les2ki/Biometric-Attendance/Firmware/view frame.py/frame_231503.png

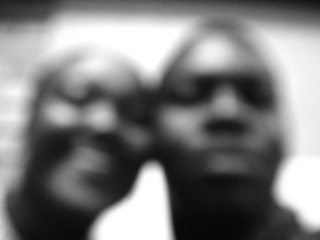
Firmware/view frame.py/frame_231503.png
