les2ki/Biometric-Attendance/Firmware/view frame.py/frame.png

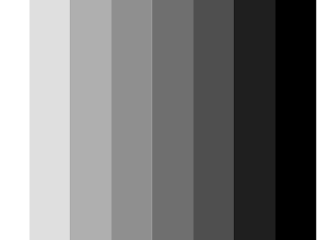
Firmware/view frame.py/frame.png
