les2ki/Biometric-Attendance/Firmware/view frame.py/frame_052043.png

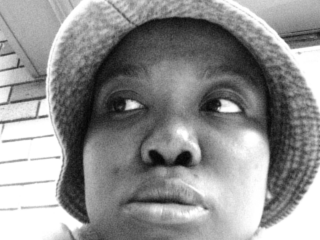
Firmware/view frame.py/frame_052043.png
