les2ki/Biometric-Attendance/Firmware/view frame.py/frame_225407.png

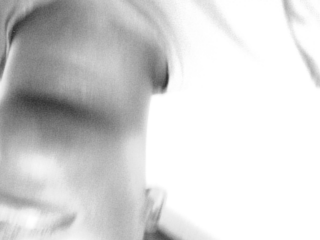
Firmware/view frame.py/frame_225407.png
