les2ki/Biometric-Attendance/Firmware/view frame.py/frame_225836_1.png

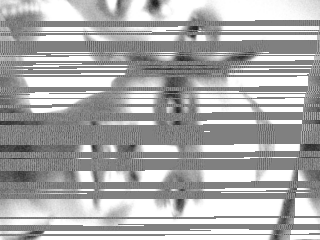
Firmware/view frame.py/frame_225836_1.png
