les2ki/Biometric-Attendance/Firmware/view frame.py/frame_225837_2.png

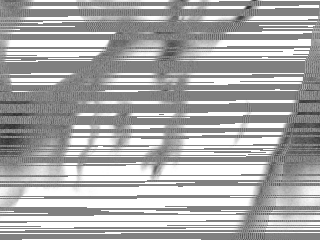
Firmware/view frame.py/frame_225837_2.png
