les2ki/Biometric-Attendance/Firmware/view frame.py/frame_225838_3.png

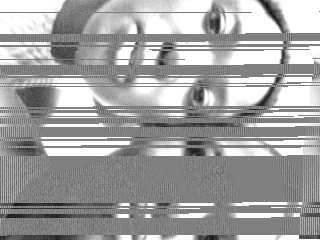
Firmware/view frame.py/frame_225838_3.png
