les2ki/Biometric-Attendance/Firmware/view frame.py/frame_225839_4.png

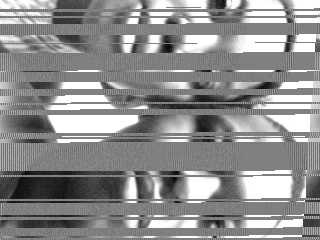
Firmware/view frame.py/frame_225839_4.png
