les2ki/Biometric-Attendance/Firmware/view frame.py/frame_225841_5.png

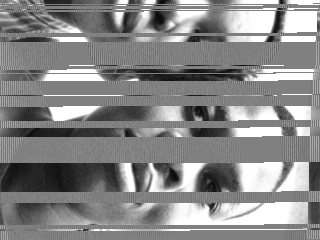
Firmware/view frame.py/frame_225841_5.png
