les2ki/Biometric-Attendance/Firmware/view frame.py/frame_225950_1.png

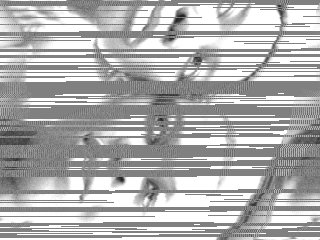
Firmware/view frame.py/frame_225950_1.png
