les2ki/Biometric-Attendance/Firmware/view frame.py/frame_225951_2.png

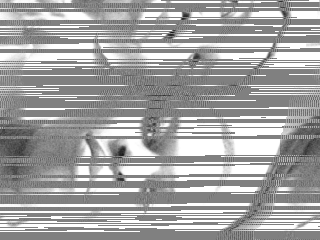
Firmware/view frame.py/frame_225951_2.png
