les2ki/Biometric-Attendance/Firmware/view frame.py/frame_225953_3.png

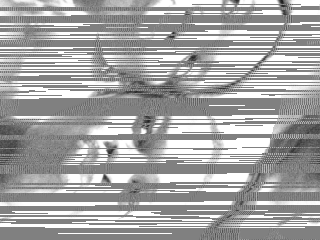
Firmware/view frame.py/frame_225953_3.png
