les2ki/Biometric-Attendance/Firmware/view frame.py/frame_225955_5.png

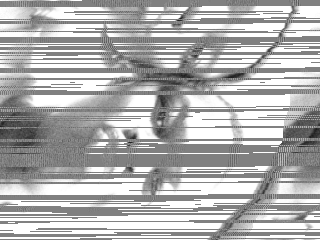
Firmware/view frame.py/frame_225955_5.png
