les2ki/Biometric-Attendance/Firmware/view frame.py/frame_231346_1.png

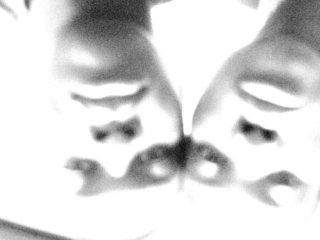
Firmware/view frame.py/frame_231346_1.png
