les2ki/Biometric-Attendance/Firmware/view frame.py/frame_231349_4.png

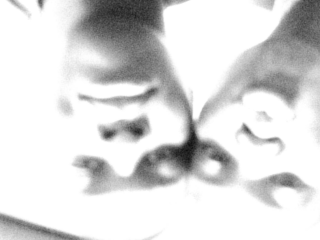
Firmware/view frame.py/frame_231349_4.png
