les2ki/Biometric-Attendance/Firmware/view frame.py/frame_231351_5.png

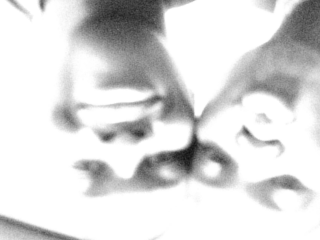
Firmware/view frame.py/frame_231351_5.png
