les2ki/Biometric-Attendance/Firmware/view frame.py/frame_231426.png

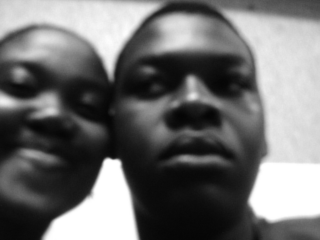
Firmware/view frame.py/frame_231426.png
