les2ki/Biometric-Attendance/Firmware/view frame.py/frame_231558.png

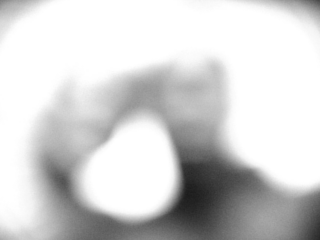
Firmware/view frame.py/frame_231558.png
