les2ki/Biometric-Attendance/Firmware/view frame.py/frame_231648.png

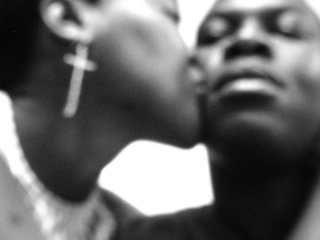
Firmware/view frame.py/frame_231648.png
