les2ki/Biometric-Attendance/Firmware/view frame.py/frame_231716.png

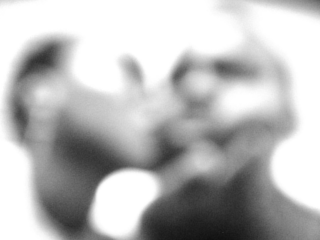
Firmware/view frame.py/frame_231716.png
