les2ki/Biometric-Attendance/Firmware/view frame.py/frame_231738.png

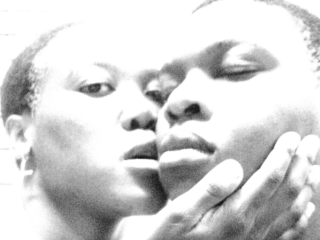
Firmware/view frame.py/frame_231738.png
