les2ki/Biometric-Attendance/Firmware/view frame.py/frame_231757.png

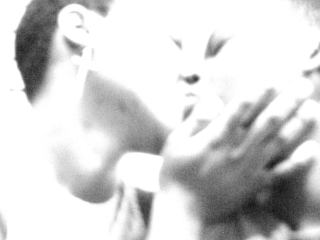
Firmware/view frame.py/frame_231757.png
