les2ki/Biometric-Attendance/Firmware/view frame.py/frame_231826.png

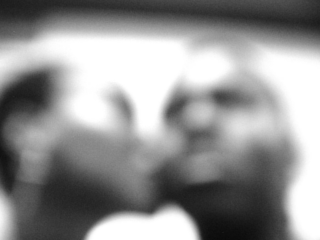
Firmware/view frame.py/frame_231826.png
