les2ki/Biometric-Attendance/Firmware/view frame.py/frame_231942.png

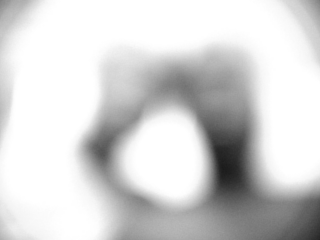
Firmware/view frame.py/frame_231942.png
