les2ki/Biometric-Attendance/Firmware/view frame.py/frame_232049.png

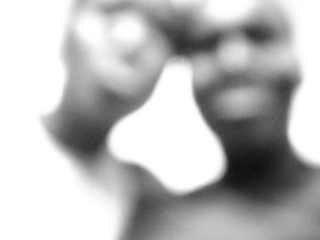
Firmware/view frame.py/frame_232049.png
