les2ki/Biometric-Attendance/Firmware/view frame.py/frame_232115.png

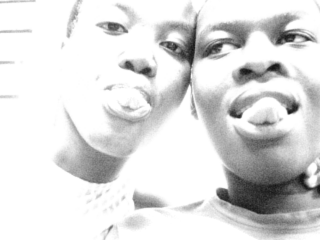
Firmware/view frame.py/frame_232115.png
