les2ki/Biometric-Attendance/Firmware/view frame.py/frame_232150.png

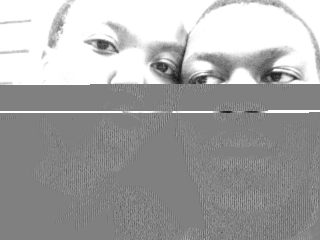
Firmware/view frame.py/frame_232150.png
