les2ki/Biometric-Attendance/Firmware/view frame.py/frame_232150_stretched.png

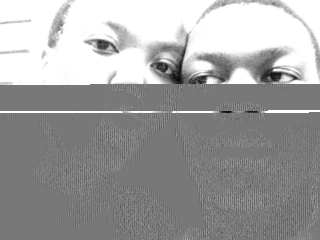
Firmware/view frame.py/frame_232150_stretched.png
