les2ki/Biometric-Attendance/Firmware/view frame.py/frame_232219.png

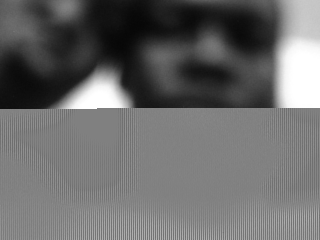
Firmware/view frame.py/frame_232219.png
