les2ki/Biometric-Attendance/Firmware/view frame.py/frame_232310.png

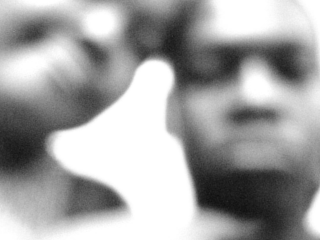
Firmware/view frame.py/frame_232310.png
