les2ki/Biometric-Attendance/Firmware/view frame.py/frame_232332.png

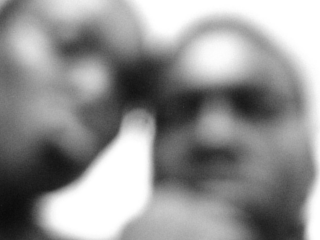
Firmware/view frame.py/frame_232332.png
