les2ki/Biometric-Attendance/Firmware/view frame.py/frame_232407.png

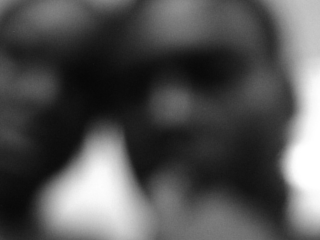
Firmware/view frame.py/frame_232407.png
