les2ki/Biometric-Attendance/Firmware/view frame.py/frame_232428.png

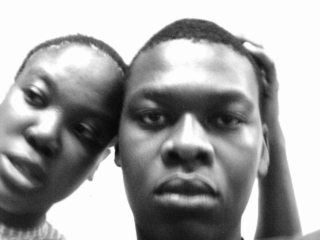
Firmware/view frame.py/frame_232428.png
