les2ki/Biometric-Attendance/Firmware/view frame.py/frame_232450.png

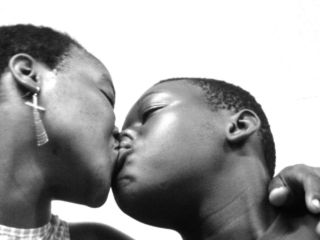
Firmware/view frame.py/frame_232450.png
