les2ki/Biometric-Attendance/docs/hardware/fingerprint-wiring.png

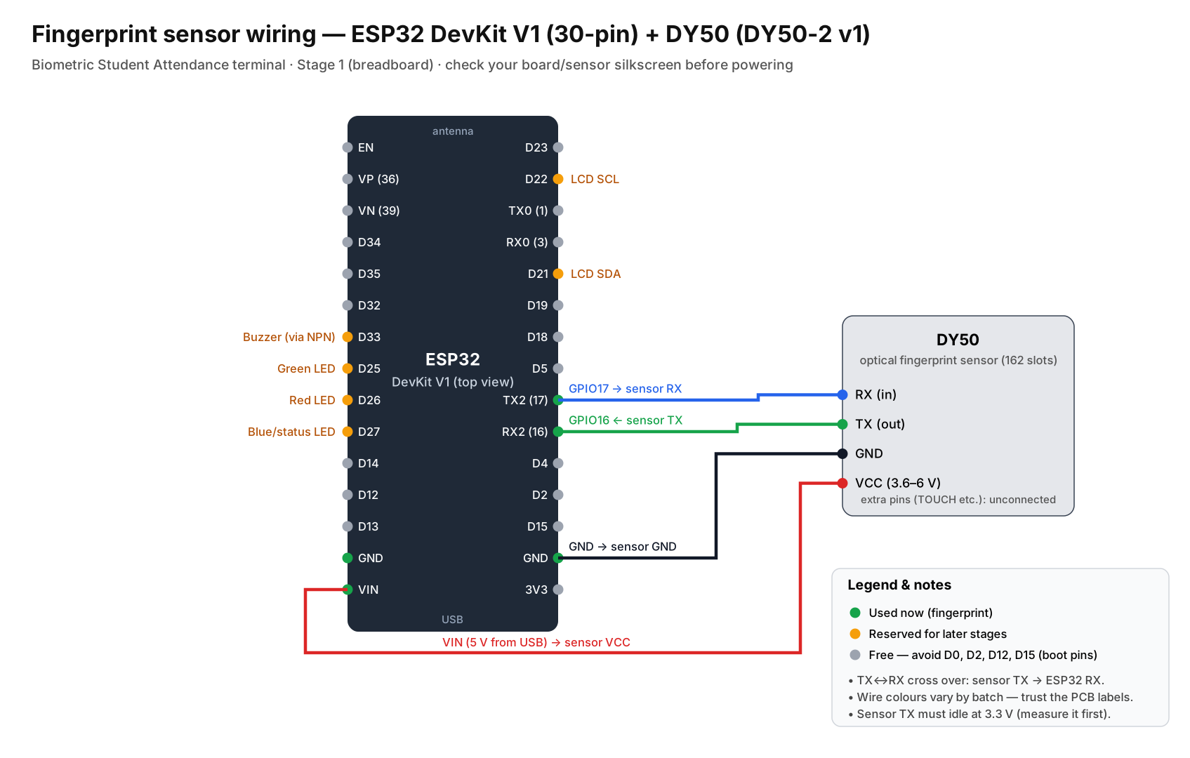
docs/hardware/fingerprint-wiring.png
