les2ki/Biometric-Attendance/(commit log)

2026-11-01 camera stuff
2026-11-02 Fix terminal liveness, face fields, and dashboard API handling
    [terminal.ino]
